mkanoap/hunger-cube/hardware/box.dxf

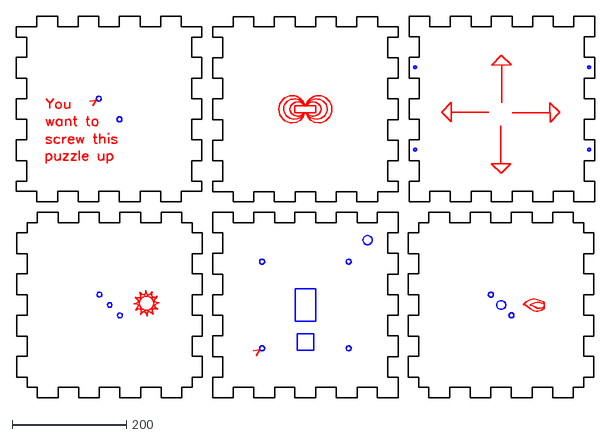
[picture p1: CAD file, 2013-03-23]
hardware/box.dxf
1010.1 x 666.4
