mkanoap/hunger-cube/hardware/hunger cube.brd

## EAGLE design hardware/hunger cube.brd (2013-06-29)

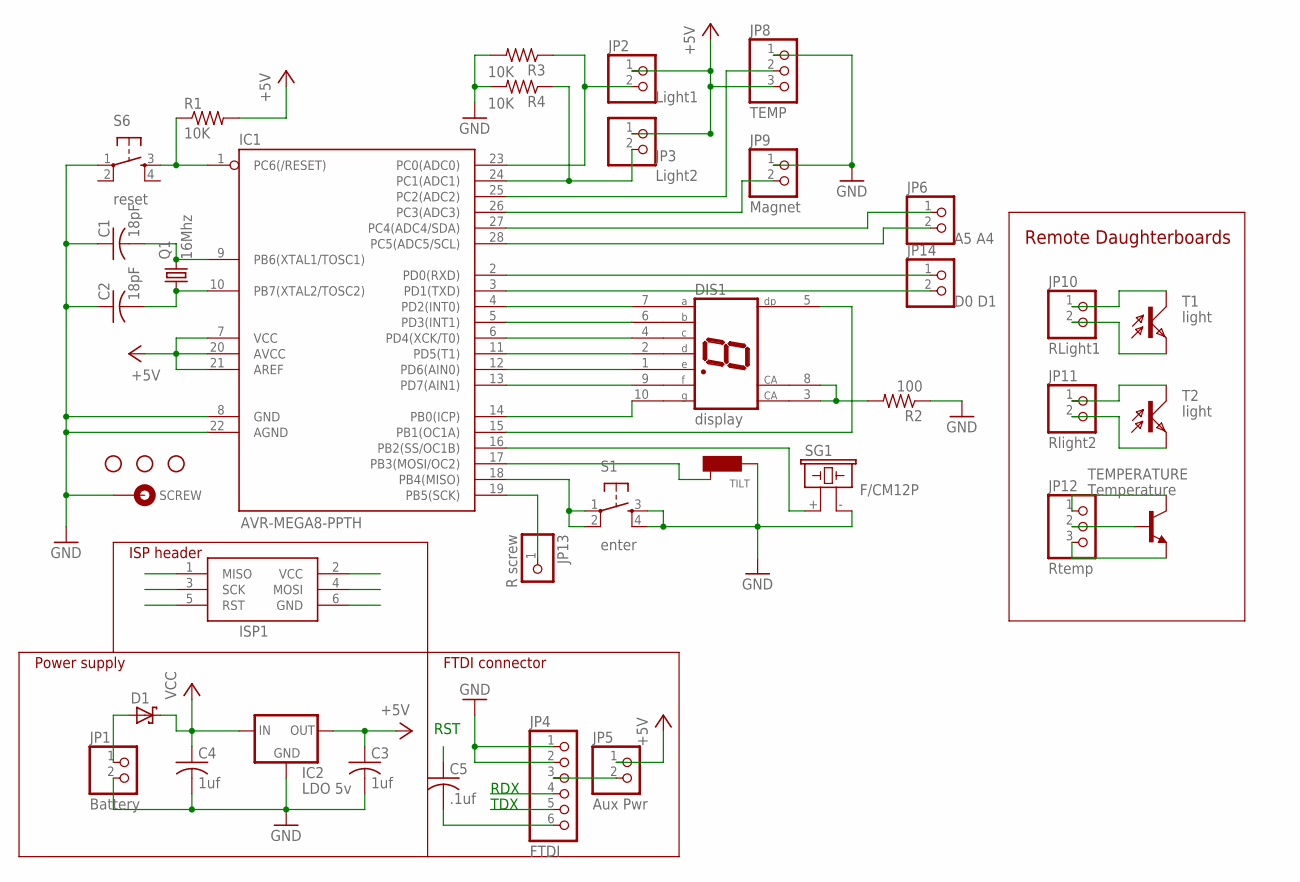
[picture p2: schematic hunger cube.sch]

Parts:
C1, C2: 18pF; C025-050X050
C3, C4: 1uf; C025-050X050
C5: .1uf; C025-050X050
D1: SCHOTTKY-DIODEDO41; DO41-10
DIS1: display; HDSP-M
IC1: AVR-MEGA8-PPTH; DIL28-3
IC2: LDO 5v; TO92-INLINE
ISP1: AVRISP-6; AVRISP
JP1: Battery; 1X02
JP2: Light1; 1X02
JP3: Light2; 1X02
JP4: FTDI; 1X06
JP5: Aux Pwr; 1X02
JP6: A5 A4; 1X02
JP7: Connected screw hole; SCREW-HOLE-PAD
JP8: TEMP; 1X03
JP9: Magnet; 1X02
JP10: RLight1; 1X02
JP11: Rlight2; 1X02
JP12: Rtemp; 1X03
JP13: R screw; 1X01
JP14: D0 D1; 1X02
Q1: 16Mhz; HC49US
R1, R3, R4: 10K; 0207/12
R2: 100; 0207/12
S1: enter; TACTILE-PTH
S6: reset; TACTILE-PTH
SG1: F/CM12P
ST1, ST2, ST3: STAND-OFF
T1, T2: light; BPX81
TEMPERATURE: Temperature; TO92-EBC
TILT: TILT-SENSOR; TILT

Connections:
+5V: C3.1, IC1.7 (VCC), IC1.20 (AVCC), IC1.21 (AREF), IC2.3 (OUT), ISP1.2 (VCC), JP2.1, JP3.1, JP5.1, JP8.3, R1.2
A0-LIGHT1: IC1.23 (PC0(ADC0)), JP2.2, R3.1
A1-LIGHT2: IC1.24 (PC1(ADC1)), JP3.2, R4.1
A2-TEMP: IC1.25 (PC2(ADC2)), JP8.2
A3-MAGNET: IC1.26 (PC3(ADC3)), JP9.2
A4: IC1.27 (PC4(ADC4/SDA)), JP6.1
A5: IC1.28 (PC5(ADC5/SCL)), JP6.2
D0-RDX: IC1.2 (PD0(RXD)), JP4.4, JP14.1
D1-TDX: IC1.3 (PD1(TXD)), JP4.5, JP14.2
D2-SEGA: DIS1.7 (A), IC1.4 (PD2(INT0))
D3-SEBB: DIS1.6 (B), IC1.5 (PD3(INT1))
D4-SEGC: DIS1.4 (C), IC1.6 (PD4(XCK/T0))
D5-SEGD: DIS1.2 (D), IC1.11 (PD5(T1))
D6-SEGE: DIS1.1 (E), IC1.12 (PD6(AIN0))
D7-SEGF: DIS1.9 (F), IC1.13 (PD7(AIN1))
D8-SEGG: DIS1.10 (G), IC1.14 (PB0(ICP))
D9-DP: DIS1.5 (DP), IC1.15 (PB1(OC1A))
D10-BUZZER: IC1.16 (PB2(SS/OC1B)), SG1.+ (1)
D11-MOSI-TILT: IC1.17 (PB3(MOSI/OC2)), ISP1.4 (MOSI), TILT.SLEEVE
D12-MISO-ENTER: IC1.18 (PB4(MISO)), ISP1.1 (MISO), S1.1, S1.2
D13-SCK-SCREW: IC1.19 (PB5(SCK)), ISP1.3 (SCK), JP13.1
DSP-GND: DIS1.3 (CA), DIS1.8 (CA), R2.2
GND: C1.1, C2.1, C3.2, C4.2, IC1.8 (GND), IC1.22 (AGND), IC2.1 (GND), ISP1.6 (GND), JP1.2, JP4.1, JP4.2, JP7.SCREW, JP8.1, JP9.1, R2.1, R3.2, R4.2, S1.3, S1.4, S6.1, SG1.- (2), TILT.CENTER
unnamed: C5.2, JP4.6
unnamed: D1.A, JP1.1
unnamed: C1.2, IC1.9 (PB6(XTAL1/TOSC1)), Q1.2
unnamed: C2.2, IC1.10 (PB7(XTAL2/TOSC2)), Q1.1
unnamed: JP4.3, JP5.2
unnamed: JP10.2, T1.E
unnamed: JP11.2, T2.E
unnamed: JP11.1, T2.C
unnamed: JP10.1, T1.C
unnamed: JP12.3, TEMPERATURE.E
unnamed: JP12.2, TEMPERATURE.B
unnamed: JP12.1, TEMPERATURE.C
RST: C5.1, IC1.1 (PC6(/RESET)), ISP1.5 (RST), R1.1, S6.3
VCC: C4.1, D1.C, IC2.2 (IN)

Notes on the sheet:
RDX
TDX
RST
Power supply
ISP header
FTDI connector
Remote Daughterboards

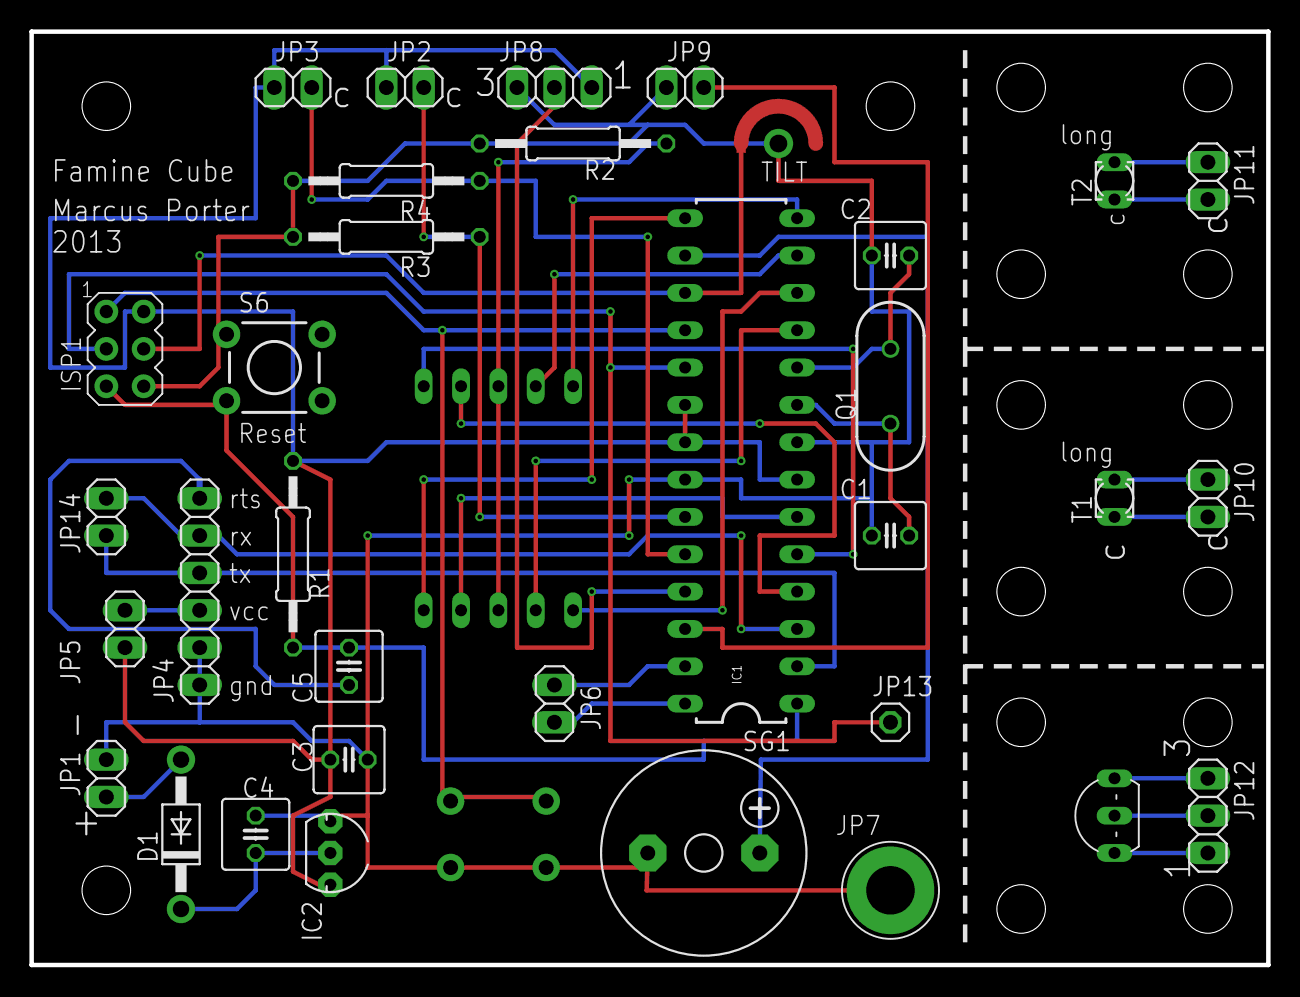
[picture p3: board hunger cube.brd from above]

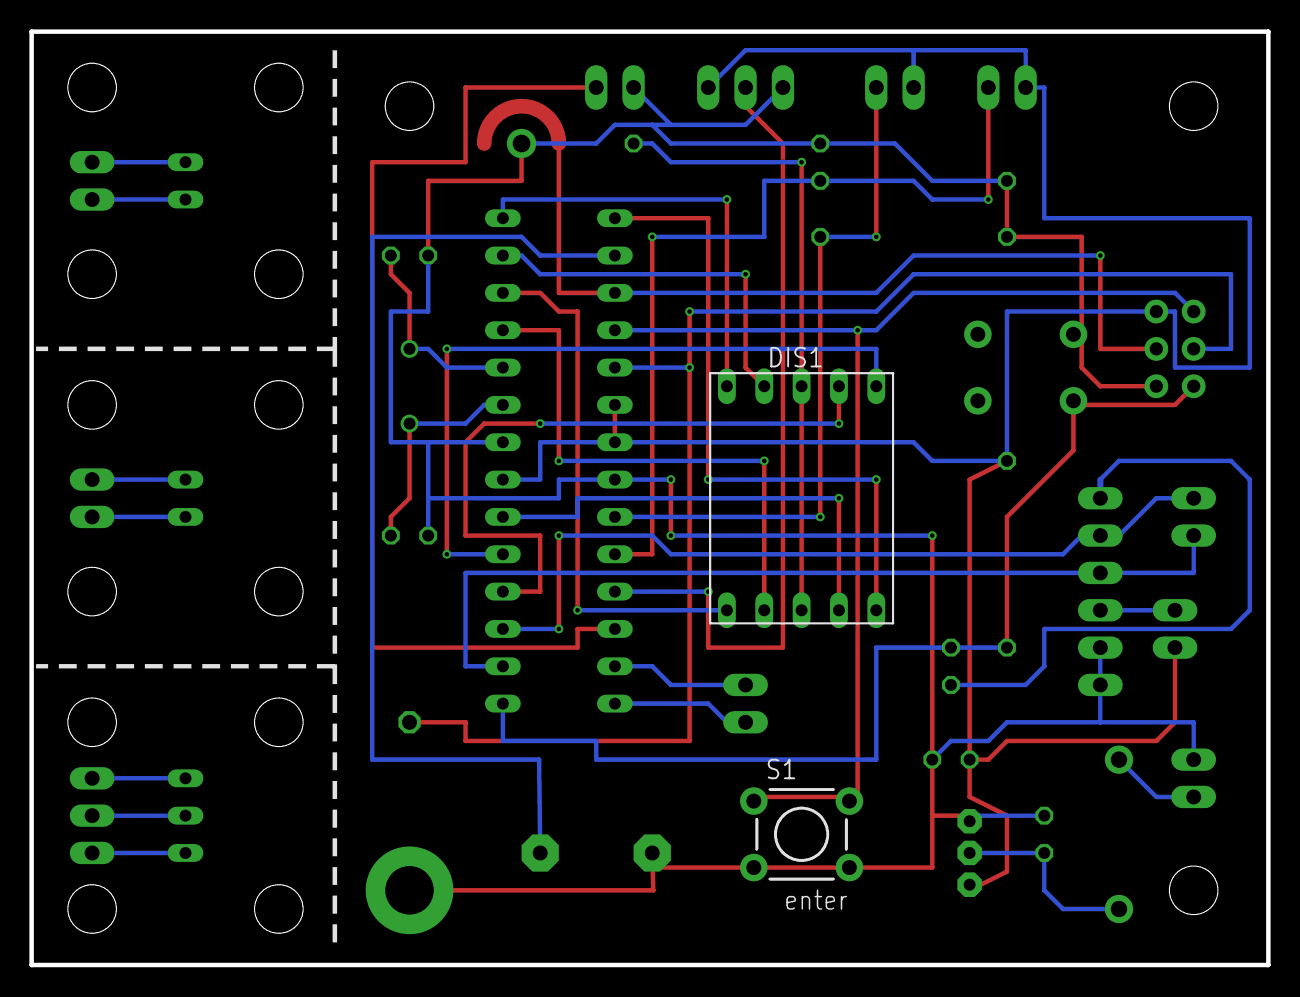
[picture p4: board hunger cube.brd from below]

Board: 2 copper layers, 84.1 x 63.5 mm, 39 parts (2 on the bottom side), 37 nets.
