mkanoap/hunger-cube/(commit log)

2013-03-05 implemented light, magnet and temperature sensors.
2013-03-14 added custom parts for tilt sensor and the secret screw. Laid out board for the first time.
    [hunger cube.brd, hunger cube.sch]
2013-03-20 Added box svg to archive, measured dimentions of parts of board for box, and tweaked where some holes are.
    [hunger cube.brd, hunger cube.sch]
